RoSE-Lab-Admin/ipex-rover/src/ipex_description/meshes/front_left_drum_1.stl

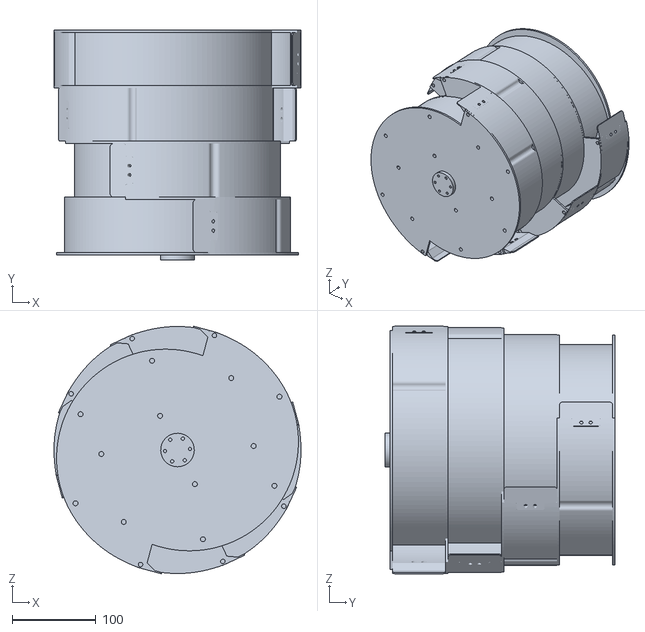
[picture p1: CAD file, 2026-11-03]
src/ipex_description/meshes/front_left_drum_1.stl
295.0 x 275.0 x 295.8
