RoSE-Lab-Admin/ipex-rover/src/ipex_description/meshes/back_left_wheel_1.stl

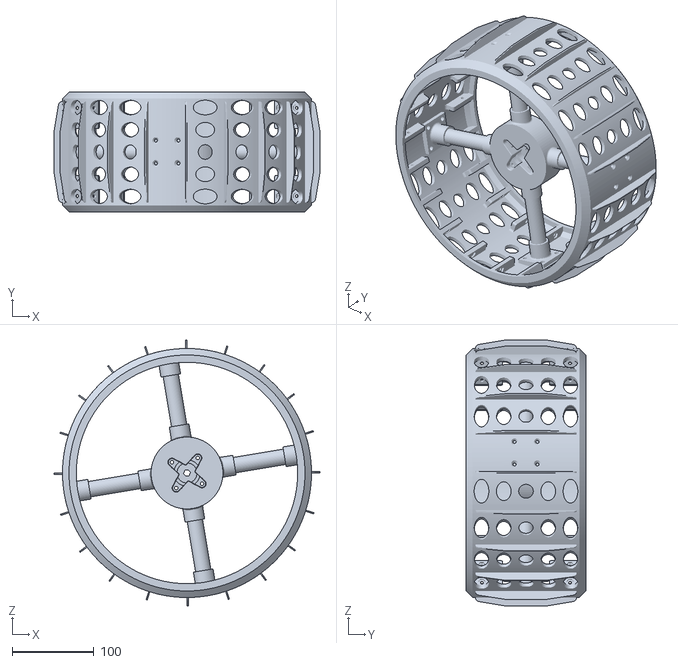
[picture p2: CAD file, 2026-11-03]
src/ipex_description/meshes/back_left_wheel_1.stl
325.8 x 147.0 x 325.8
