RoSE-Lab-Admin/ipex-rover/src/ipex_description/meshes/D435_camera_front_1.stl

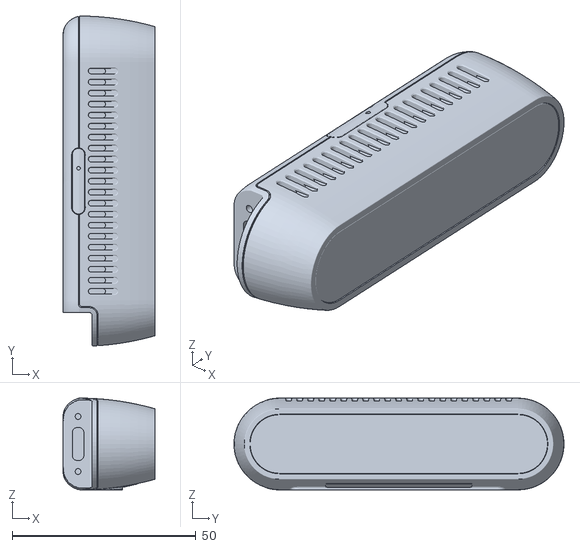
[picture p3: CAD file, 2026-11-03]
src/ipex_description/meshes/D435_camera_front_1.stl
25.0 x 89.9 x 25.0
