RoSE-Lab-Admin/ipex-rover/src/ipex_description/meshes/base_link.stl

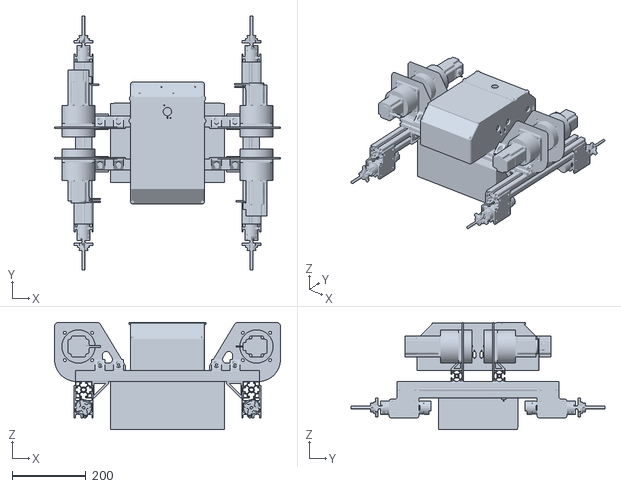
[picture p4: CAD file, 2026-11-03]
src/ipex_description/meshes/base_link.stl
612.5 x 688.0 x 290.0
