RoSE-Lab-Admin/ipex-rover/src/ipex_description/meshes/back_arm_1.stl

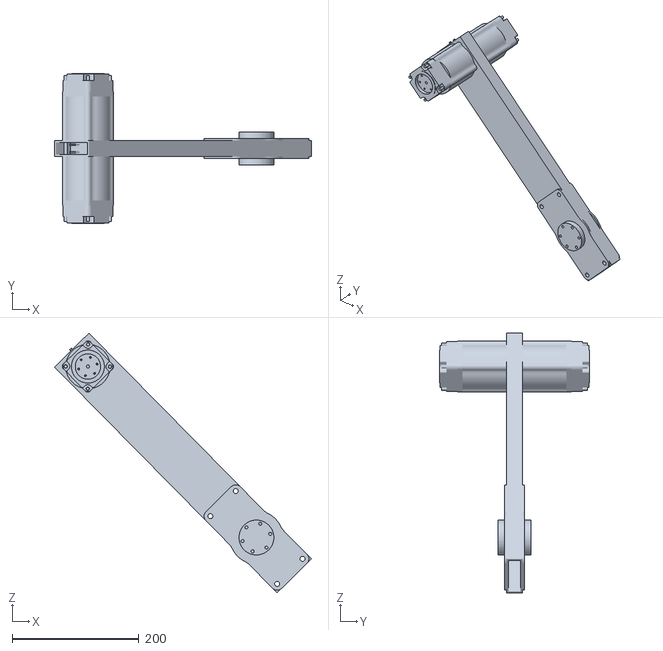
[picture p5: CAD file, 2026-09-17]
src/ipex_description/meshes/back_arm_1.stl
405.3 x 236.2 x 409.5
