RoSE-Lab-Admin/ipex-rover/src/ipex_description/meshes/front_left_wheel_1.stl

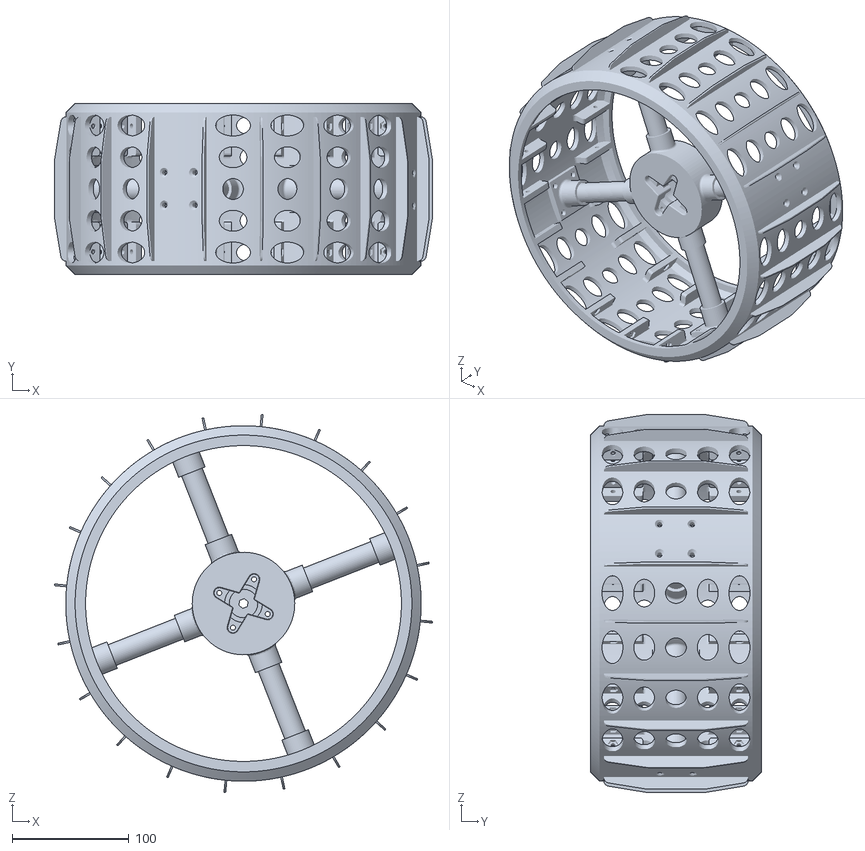
[picture p6: CAD file, 2026-09-17]
src/ipex_description/meshes/front_left_wheel_1.stl
324.4 x 147.0 x 324.4
