RoSE-Lab-Admin/ipex-rover/src/ipex_description/meshes/front_arm_1.stl

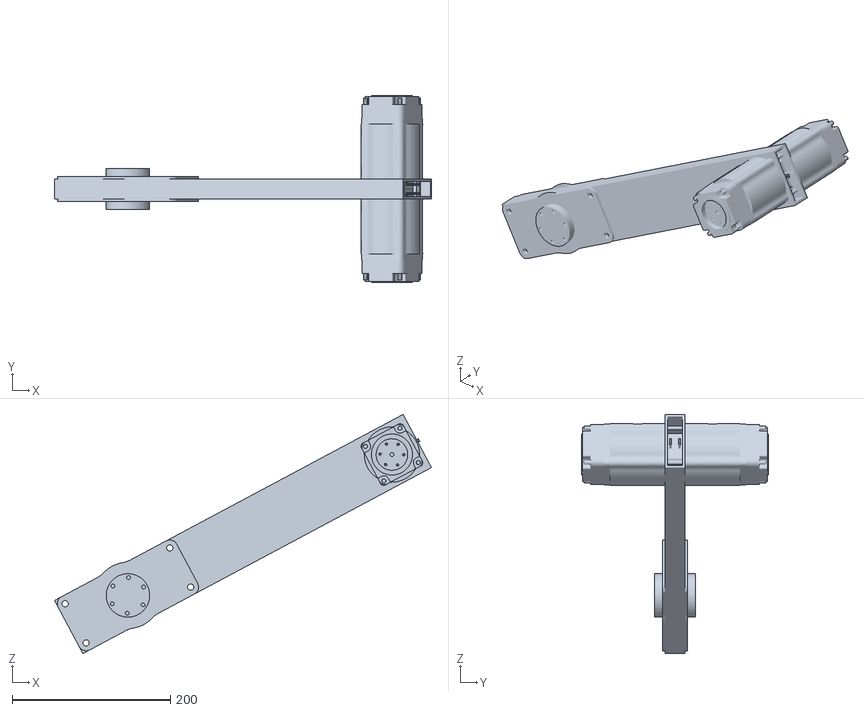
[picture p7: CAD file, 2026-09-17]
src/ipex_description/meshes/front_arm_1.stl
477.0 x 236.2 x 302.6
