RoSE-Lab-Admin/ipex-rover/(list of files, cad)

Other CAD files:
src/ipex_description/meshes/front_right_drum_1.stl
src/ipex_description/meshes/back_left_drum_1.stl
src/ipex_description/meshes/back_right_drum_1.stl
src/ipex_description/meshes/D435_camera_rear_1.stl
src/ipex_description/meshes/front_right_wheel_1.stl
src/ipex_description/meshes/back_right_wheel_1.stl
