RoSE-Lab-Admin/ipex-rover/src/ipex_bringup/config/controllers.yaml

controller_manager:
  ros__parameters:
    update_rate: 50

    joint_state_broadcaster:
      type: joint_state_broadcaster/JointStateBroadcaster

    # One shoulder + one drum controller per arm, so each arm can be
    # spawned independently (one Teensy per arm; front arm may be absent).
    front_shoulder_controller:
      type: position_controllers/JointGroupPositionController

    rear_shoulder_controller:
      type: position_controllers/JointGroupPositionController

    front_drum_controller:
      type: velocity_controllers/JointGroupVelocityController

    rear_drum_controller:
      type: velocity_controllers/JointGroupVelocityController

    diff_drive_controller:
      type: diff_drive_controller/DiffDriveController

front_shoulder_controller:
  ros__parameters:
    joints:
      - front_shoulder_rev

rear_shoulder_controller:
  ros__parameters:
    joints:
      - back_shoulder_rev

front_drum_controller:
  ros__parameters:
    joints:
      - front_left_drum_rev
      - front_right_drum_rev

rear_drum_controller:
  ros__parameters:
    joints:
      - back_left_drum_rev
      - back_right_drum_rev

diff_drive_controller:
  ros__parameters:
    left_wheel_names:
      - front_left_wheel_rev
      - back_left_wheel_rev

    right_wheel_names:
      - front_right_wheel_rev
      - back_right_wheel_rev

    wheel_separation: 0.582

    # Measured 31 cm tire diameter (CAD outer: ~0.163 m).
    # Calibrate by driving a known distance. Must match ipex.ros2_control.xacro.
    wheel_radius: 0.155

    # Odometry from the RoboClaw wheel encoders (wheel positions in /joint_states),
    # since 2026-10-22 after the encoder signs were verified on the rover. If the
    # encoder telemetry drops out, IpexSystem falls back to commanded velocity.
    # Set open_loop: true / position_feedback: false to go back to commanded-speed odometry.
    open_loop: false
    position_feedback: true

    odom_frame_id: odom
    base_frame_id: base_link

    enable_odom_tf: true
    cmd_vel_timeout: 0.5
