RoSE-Lab-Admin/ipex-rover/src/ipex_bringup/config/primitives.yaml

# ipex_primitives/primitive_server
primitive_server:
  ros__parameters:
    # Arms (must match firmware/arm/arm.ino ARM_MIN_DEG / ARM_MAX_DEG)
    arm_min_deg: -40.0
    arm_max_deg: 45.0
    arm_speed_deg_s: 5.625        # default arm speed (= firmware default); set_arm restores it
    arm_speed_min_deg_s: 0.5      # must match firmware ARM_SPEED_MIN_DEG_S
    arm_speed_max_deg_s: 5.625    # must match firmware ARM_SPEED_MAX_DEG_S

    # Cut depth below the tire tread plane (the rubber between the grousers; no sinkage):
    #   depth = drum_cut_radius - (pivot_height + length*sin(angle))
    arm_pivot_height_m: 0.3208    # pivot above the tread: 0.3183 above base_link + 0.0025 (axle 0.1525, tread radius 0.155).
                                  # Rover check 2026-10-31: -28.7 deg = 1 cm below the tread, measured
    arm_length_m: 0.3786          # shoulder pivot to drum axle (ipex.xacro, both arms)
    drum_cut_radius_m: 0.149      # drum tooth-tip radius (drum meshes)
    arm_tolerance_deg: 0.5        # "reached" when within this of the target
    arm_timeout_margin_s: 5.0     # added to travel time (brake release/engage, settle)

    # Drive
    max_speed_mps: 1.0            # primitives never command faster than this
    max_turn_rad_s: 1.0
    drive_timeout_factor: 1.5     # timeout = expected time x factor + margin
    drive_timeout_margin_s: 3.0
    stall_current_a: 8.5          # ACS712 drive current, /rover/<wheel>/current (RoboClaw limit is 9 A since 2026-11-13; keep 0.5 A under it)
    stall_time_s: 1.0             # at/above stall current this long -> STALL

    # Drums: primitive omega > 0 means "dig" (= hand controller D-pad right)
    # Signs belong to the physical arm; swapped with the Teensy IDs on 2026-10-22.
    # Rear flipped 2026-10-28 after the rear drum motor was rewired; both flipped
    # again 2026-10-28 after testbed runs showed the drums digging backwards.
    drum_dig_sign_front: -1.0
    drum_dig_sign_rear: -1.0
    drum_max_rad_s: 0.62832       # at the drum: 3200 motor steps/s (firmware cap) / 80:1 = 6.0 drum RPM
    drum_spinup_s: 1.0            # excavate: drums spin this long before the arms lower
    drum_stop_wait_s: 3.0         # on exit: wait (max) for odometry to show the wheels stopped...
    drum_stop_delay_s: 0.5        # ...then this long before the drums stop (drums stop last)

    # Energy
    idle_window_s: 2.0            # idle power = average power over this window before start
    energy_settle_s: 0.3

    # Run log: <data_dir>/runs/primitive_runs.csv
    data_dir: '~/roxey_data'
