RoSE-Lab-Admin/ipex-rover/src/ipex_hardware/include/ipex_hardware/ipex_arm_system.hpp

#ifndef IPEX_HARDWARE__IPEX_ARM_SYSTEM_HPP_
#define IPEX_HARDWARE__IPEX_ARM_SYSTEM_HPP_

#include <atomic>
#include <chrono>
#include <cstdint>
#include <limits>
#include <memory>
#include <string>
#include <vector>

#include "hardware_interface/system_interface.hpp"
#include "hardware_interface/types/hardware_interface_return_values.hpp"
#include "rclcpp/rclcpp.hpp"
#include "rclcpp_lifecycle/state.hpp"
#include "std_msgs/msg/bool.hpp"
#include "std_msgs/msg/empty.hpp"
#include "std_msgs/msg/float32.hpp"
#include "std_msgs/msg/float64.hpp"
#include "std_msgs/msg/int8.hpp"

#include "ipex_hardware/serial_port.hpp"

namespace ipex_hardware
{

// ros2_control hardware component for ONE arm Teensy (firmware/arm/arm.ino).
// One instance per arm, each with its own <ros2_control> block.
//
// Joints (from the URDF block):
//   - exactly one joint with a "position" command interface: the shoulder
//   - one or more joints with a "velocity" command interface: the drums
//     (all drums receive the first drum joint's command; they turn in sync)
//
// Commands -> Teensy (only when the command changes):
//   shoulder position [rad] -> "ARM <deg>"
//   drum velocity [rad/s]   -> "DRUM <steps/s>"
// Teensy -> state:
//   "STATE <homed> <deg> <activity> <steps/s>" -> shoulder position, drum velocity
//
// ROS topics (on the hardware component node):
//   /ipex/all_stop            (std_msgs/Empty, sub)  -> "STOP"
//   /ipex/home_arms           (std_msgs/Empty, sub)  -> "CAL"
//   /ipex/<arm_name>/homed    (std_msgs/Bool, pub, transient local)
//   /ipex/<arm_name>/jog      (std_msgs/Int8, sub)   +1 up / -1 down / 0 stop
//       Must be republished while held. No message within jog_timeout_ms
//       -> "JOG STOP". While jogging, "JOG UP|DOWN" keepalives are sent to
//       the Teensy every jog_keepalive_ms (Teensy stops after 250 ms without).
//   /ipex/<arm_name>/step     (std_msgs/Float64, sub) relative degrees -> "STEP <deg>"
//   /ipex/<arm_name>/goto     (std_msgs/Float64, sub) absolute degrees -> "ARM <deg>"
//       Always sent (unlike the position controller path, which only sends
//       when the target changes). Used by motion primitives.
//   /ipex/<arm_name>/speed    (std_msgs/Float64, sub) arm speed deg/s -> "ARM_SPEED <deg/s>"
//       Persists until changed (also applies to jogs). Teensy clamps to
//       [0.5, 5.625] deg/s; default after Teensy reset is 5.625. Sent before a
//       goto in the same cycle.
class IpexArmSystem : public hardware_interface::SystemInterface
{
public:
  hardware_interface::CallbackReturn on_init(
    const hardware_interface::HardwareComponentInterfaceParams & params) override;

  hardware_interface::CallbackReturn on_configure(
    const rclcpp_lifecycle::State & previous_state) override;

  hardware_interface::CallbackReturn on_activate(
    const rclcpp_lifecycle::State & previous_state) override;

  hardware_interface::CallbackReturn on_deactivate(
    const rclcpp_lifecycle::State & previous_state) override;

  hardware_interface::CallbackReturn on_cleanup(
    const rclcpp_lifecycle::State & previous_state) override;

  hardware_interface::return_type read(
    const rclcpp::Time & time,
    const rclcpp::Duration & period) override;

  hardware_interface::return_type write(
    const rclcpp::Time & time,
    const rclcpp::Duration & period) override;

private:
  void handle_line(const std::string & line);
  void publish_homed(bool homed);

  // Parameters
  std::string arm_name_;
  std::string serial_device_;
  int serial_baud_ = 115200;
  double drum_steps_per_rev_ = 400.0;
  bool home_on_activate_ = false;

  // Joints
  std::string shoulder_joint_;
  std::vector<std::string> drum_joints_;

  std::unique_ptr<SerialPort> port_;

  // Last values sent to the Teensy (NaN = nothing sent yet)
  double last_sent_shoulder_rad_;
  double last_sent_drum_rad_s_;

  bool homed_ = false;

  std::atomic<bool> stop_requested_{false};
  std::atomic<bool> home_requested_{false};

  // Jog: latest requested direction and when it arrived (steady clock, ns).
  std::atomic<int> jog_requested_dir_{0};
  std::atomic<int64_t> jog_stamp_ns_{0};
  int jog_sent_dir_ = 0;                       // Last direction sent to Teensy
  bool jog_blocked_ = false;                   // After STOP: wait for release
  std::chrono::steady_clock::time_point last_jog_sent_;
  std::chrono::milliseconds jog_timeout_{200};
  std::chrono::milliseconds jog_keepalive_{100};

  // Taps: accumulated relative degrees not yet sent.
  std::atomic<double> pending_step_deg_{0.0};

  // Absolute target requested on /goto (degrees); NaN = none pending.
  std::atomic<double> pending_goto_deg_{std::numeric_limits<double>::quiet_NaN()};

  // Arm speed requested on /speed (deg/s); NaN = none pending.
  std::atomic<double> pending_speed_deg_s_{std::numeric_limits<double>::quiet_NaN()};

  rclcpp::Subscription<std_msgs::msg::Empty>::SharedPtr all_stop_sub_;
  rclcpp::Subscription<std_msgs::msg::Empty>::SharedPtr home_sub_;
  rclcpp::Subscription<std_msgs::msg::Int8>::SharedPtr jog_sub_;
  rclcpp::Subscription<std_msgs::msg::Float64>::SharedPtr step_sub_;
  rclcpp::Subscription<std_msgs::msg::Float64>::SharedPtr goto_sub_;
  rclcpp::Subscription<std_msgs::msg::Float64>::SharedPtr speed_sub_;
  rclcpp::Publisher<std_msgs::msg::Bool>::SharedPtr homed_pub_;

  // Drum speed as reported by the Teensy (commanded; drums have no encoder):
  // /rover/<arm_name>/drum/steps_s (motor steps/s) and /drum/rpm (drum RPM).
  rclcpp::Publisher<std_msgs::msg::Float32>::SharedPtr drum_steps_pub_;
  rclcpp::Publisher<std_msgs::msg::Float32>::SharedPtr drum_rpm_pub_;
};

}  // namespace ipex_hardware

#endif  // IPEX_HARDWARE__IPEX_ARM_SYSTEM_HPP_
