RoSE-Lab-Admin/ipex-rover/src/ipex_hardware/include/ipex_hardware/serial_transport.hpp

#ifndef IPEX_HARDWARE__SERIAL_TRANSPORT_HPP_
#define IPEX_HARDWARE__SERIAL_TRANSPORT_HPP_

#include <array>
#include <memory>
#include <string>

#include "rclcpp/rclcpp.hpp"
#include "std_msgs/msg/float32.hpp"
#include "std_msgs/msg/string.hpp"

#include "ipex_hardware/drivetrain_transport.hpp"

namespace ipex_hardware
{

class SerialTransport : public DrivetrainTransport
{
public:
  SerialTransport(
    const rclcpp::Node::SharedPtr & node,
    const std::string & device,
    int baud_rate);

  ~SerialTransport() override;

  bool write(
    double left_wheel_rad_s,
    double right_wheel_rad_s) override;

  bool stop() override;

  bool send_raw(const std::string & command) override;

  WheelFeedback wheel_feedback() const override {return wheel_feedback_;}

private:
  bool open_port();
  void close_port();
  void read_available();
  void handle_line(const std::string & line);

  void publish_voltages(
    float back_left,
    float back_right,
    float front_right,
    float front_left);

  void publish_currents(
    float back_left,
    float back_right,
    float front_right,
    float front_left);

  // Arm power sensors (read by the drivetrain Teensy). Index order:
  //   0 rear drum, 1 rear shoulder, 2 front drum, 3 front shoulder.
  void publish_arm_values(
    const std::array<rclcpp::Publisher<std_msgs::msg::Float32>::SharedPtr, 4> & pubs,
    const float values[4]);

  std::array<rclcpp::Publisher<std_msgs::msg::Float32>::SharedPtr, 4> arm_current_pubs_;
  std::array<rclcpp::Publisher<std_msgs::msg::Float32>::SharedPtr, 4> arm_voltage_pubs_;

  // Motor currents measured by the RoboClaws. Index order (same as CURR):
  //   0 back left, 1 back right, 2 front right, 3 front left.
  std::array<rclcpp::Publisher<std_msgs::msg::Float32>::SharedPtr, 4> roboclaw_current_pubs_;

  // Measured wheel speed (rad/s) from the RoboClaw encoders, same order:
  // /rover/<wheel>/speed. Positions go to ros2_control only (joint_states).
  std::array<rclcpp::Publisher<std_msgs::msg::Float32>::SharedPtr, 4> wheel_speed_pubs_;
  WheelFeedback wheel_feedback_;

  // Battery voltage sensors: 0 drivetrain battery, 1 Pi / arm battery.
  std::array<rclcpp::Publisher<std_msgs::msg::Float32>::SharedPtr, 2> battery_voltage_pubs_;

  // Calibration replies from the Teensy ("CAL_..." and "# CAL ..." lines),
  // republished as-is on /ipex/drivetrain/reply for `roxey cal`.
  rclcpp::Publisher<std_msgs::msg::String>::SharedPtr reply_pub_;

  rclcpp::Node::SharedPtr node_;

  rclcpp::Publisher<std_msgs::msg::Float32>::SharedPtr back_left_voltage_pub_;
  rclcpp::Publisher<std_msgs::msg::Float32>::SharedPtr back_right_voltage_pub_;
  rclcpp::Publisher<std_msgs::msg::Float32>::SharedPtr front_right_voltage_pub_;
  rclcpp::Publisher<std_msgs::msg::Float32>::SharedPtr front_left_voltage_pub_;

  rclcpp::Publisher<std_msgs::msg::Float32>::SharedPtr back_left_current_pub_;
  rclcpp::Publisher<std_msgs::msg::Float32>::SharedPtr back_right_current_pub_;
  rclcpp::Publisher<std_msgs::msg::Float32>::SharedPtr front_right_current_pub_;
  rclcpp::Publisher<std_msgs::msg::Float32>::SharedPtr front_left_current_pub_;

  std::string device_;
  int baud_rate_;
  int fd_ = -1;

  std::string rx_buffer_;
};

}  // namespace ipex_hardware

#endif
