RoSE-Lab-Admin/ipex-rover/src/ipex_hardware/include/ipex_hardware/ipex_system.hpp

#ifndef IPEX_HARDWARE__IPEX_SYSTEM_HPP_
#define IPEX_HARDWARE__IPEX_SYSTEM_HPP_

#include <atomic>
#include <memory>
#include <string>

#include "hardware_interface/system_interface.hpp"
#include "hardware_interface/types/hardware_interface_return_values.hpp"
#include "rclcpp/rclcpp.hpp"
#include "rclcpp_lifecycle/state.hpp"
#include "std_msgs/msg/empty.hpp"
#include "std_msgs/msg/string.hpp"

#include "ipex_hardware/drivetrain_transport.hpp"

namespace ipex_hardware
{

class IpexSystem : public hardware_interface::SystemInterface
{
public:
  hardware_interface::CallbackReturn on_init(
    const hardware_interface::HardwareComponentInterfaceParams & params) override;

  hardware_interface::CallbackReturn on_configure(
    const rclcpp_lifecycle::State & previous_state) override;

  hardware_interface::CallbackReturn on_activate(
    const rclcpp_lifecycle::State & previous_state) override;

  hardware_interface::CallbackReturn on_deactivate(
    const rclcpp_lifecycle::State & previous_state) override;

  hardware_interface::return_type read(
    const rclcpp::Time & time,
    const rclcpp::Duration & period) override;

  hardware_interface::return_type write(
    const rclcpp::Time & time,
    const rclcpp::Duration & period) override;

private:
  std::unique_ptr<DrivetrainTransport> drivetrain_transport_;

  double wheel_radius_ = 0.0;
  double wheel_separation_ = 0.0;

  std::string drivetrain_serial_device_;
  int drivetrain_serial_baud_ = 115200;

  // Wheel state from RoboClaw encoders (falls back to commanded when stale).
  bool use_wheel_feedback_ = true;
  bool wheel_feedback_active_ = false;
  bool wheel_feedback_logged_ = false;   // startup mode logged yet?
  // Encoder position minus reported position, per WheelFeedback index; set when
  // measured data starts so the reported position is continuous.
  std::array<double, 4> position_offset_{};
  int wheel_feedback_reads_ = 0;

  // ALL STOP: /ipex/all_stop (std_msgs/Empty) -> "STOP" to the drivetrain.
  std::atomic<bool> stop_requested_{false};
  rclcpp::Subscription<std_msgs::msg::Empty>::SharedPtr all_stop_sub_;

  // Calibration: /ipex/drivetrain/command (std_msgs/String), only CAL_CURRENT,
  // CAL_ARM_CURRENT or CAL_SHOW; sent instead of DRIVE on the next write().
  // Index into kCalCommands + 1 (0 = nothing pending). Replies come back on
  // /ipex/drivetrain/reply (SerialTransport). Used by `roxey cal`.
  std::atomic<int> pending_command_{0};
  rclcpp::Subscription<std_msgs::msg::String>::SharedPtr command_sub_;
};

}  // namespace ipex_hardware

#endif
