RoSE-Lab-Admin/ipex-rover/(commit log)

2026-09-17 PreCleanup Baseline Screenshot
    [back_arm_1.stl, back_left_wheel_1.stl, back_right_wheel_1.stl, controller.yaml, controllers.yaml, front_arm_1.stl, front_left_wheel_1.stl, front_right_wheel_1.stl]
2026-09-17 Clean Baseline
    [ipex.ros2_control.xacro]
2026-09-27 Added sensor directory and speed toggles
2026-10-08 Firmware and controller.py upgrades for hand controller use
    [controllers.yaml, ipex.ros2_control.xacro]
2026-10-08 Front arm teensy id added
    [ipex.ros2_control.xacro]
2026-10-08 A button calibration
2026-10-09 Enable rear arm by default
    [ipex.ros2_control.xacro]
2026-10-09 drum direction rear teensy sign flip
    [teleop.yaml]
2026-10-11 Updated firmware for PID control
2026-10-14 Continuous movement JOG function for arm, continuous drum movement while arms move
2026-10-15 Arm current voltage
2026-10-16 Battery voltage sensors, roboclaw current topic
2026-10-18 Drivetrain current sensor scaling, lightened smooting on pid control
2026-10-18 Current sensor scaling fixed, EEPROM calibration, temp sensor addresses fixed
2026-10-18 voltage sensor calibration values
2026-10-21 Cut depth and roboclaw velocity reading
2026-10-22 Arm direction update, fixed example mission, ctrl c all stop
2026-10-22 DT encoder values published
2026-10-28 Drum gear ratio added, drum speed in RPM on dpad
2026-10-28 excavate loop on controller x button
2026-10-28 controller excavation mode arm step degree increase
2026-10-28 arm movement speed during excavation tuning
2026-10-31 imu config tests
2026-10-31 IMU set mag ref and zero gyros at boot
2026-11-01 Better cut depth measurements
2026-11-03 v1.3 URDF w/ sensor frames
2026-11-03 v1.3 URDF
2026-11-09 Temporary speed adjustments for excavation mode only for 188:1 gearbox testing
2026-11-11 188:1 gearbox updates
2026-11-12 Sign fixes for current readings and energy consumption math.
2026-11-12 Sign fix in teensy
2026-11-13 Updated stall current limit based on updated roboclaw amperage
2026-11-13 CLI tool for raw sensor readings
2026-11-13 cli tools for calibration
2026-11-13 Drive motor energy readings abs value
